anujajoshi758/Golden-Arduino/README.md

# Golden-Arduino
[Report link](https://github.com/anujajoshi758/Golden-Arduino/blob/main/board_3_report.pdf)
