anujajoshi758/Golden-Arduino/(list of files, drawings)

Other design files:
PCB_board3.PcbDoc
PCB_board3.PrjPcb
Sheet1.SchDoc
